sw9/robockey/(commit log)

2016-12-06 changed the pin assignments to free up ADC pins as much as possible, added comm test code, added part of puck detection code
2016-12-06 fixed bug with moving to incorrect goal
    [main.c]
